DavidMarzocca/NMLB/(threads)

Thread 1 (2018-09-03):

Pins definition

ssombra, 2018-09-03:
Looking forward to build your project. After just having a look at the code, in the section where the Pins are defined, shouldn't be CHOut instead of CEOut?

DavidMarzocca, 2018-09-03:
Hi, yes thanks a lot! I corrected this on my local version when I compiled the code but forgot to update it here. Now the variable is defined as CEout (Charge Enabler output).
The variable controls when to turn on or off the TP4056. I set it up so that the lipo gets charged at max ~4.0V, which should prolong its lifetime if it is left for long periods without use, at the price of a slightly smaller autonomy (it's extremely long in any case..).

ssombra, 2018-09-03:
Good. And talking about the TP4056, do I need to change something in the code if I am not using it?

DavidMarzocca, 2018-09-03:
No, you can leave it as it is. Simply in that case it won't matter if the CEout pin is enabled or disabled, you can also remove those lines if you want.

ssombra, 2018-09-03:
Thanks. I'll give it a try.

Thread 2 (2020-07-20):

LED blinks only every 45 seconds

Calimerorulez, 2020-07-20:
Hi!

I came across your awesomized DIY project, so I made the PCB and soldered the components. I've flashed the ATTINY85, when I power on the buzzer, it beeps (sometimes twice), but the LED only flashes every 45 seconds or so. And not every 3 seconds.

I've flashed the ATTINY with Arduino IDE, and set a internal CPU speed if 16MHz? Is there something that I'm missing?

Thank you for your work and help :)
